simple-circuit/Pico-Thermal-Resistance-Testing/README.md

# Pico-Thermal-Resistance-Testing
Measure the junction to ambient thermal resistance of a 1N914 diode using your Pico processor. 
The 1N914 diode is used as the heat source and temperature measurement device.
